mcgurk/Controller_adapter_for_NES/README.md

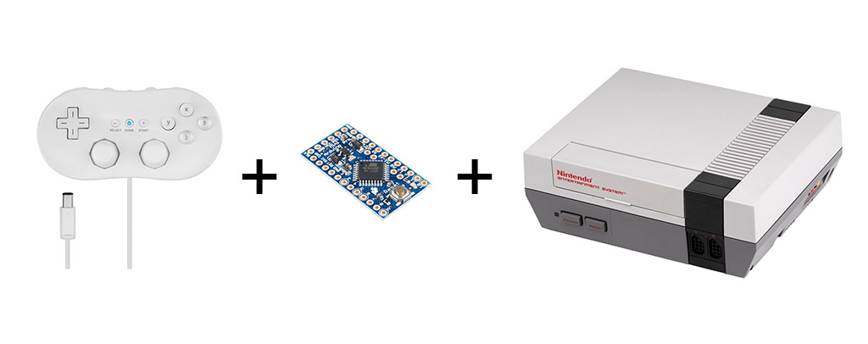
[picture p1: Images/Wii-Classic-Controller_Arduino_NES.jpg]


# Wii Classic Controller to NES

Works with normal Arduino with Atmega328P (5V 16MHz). I used Arduino Pro Mini (Arduino Pro Mini doesn't include USB-port - needs USB-serial adapter for programming). Arduino Nano may be better option, because it includes USB-port.

Lag under 1ms.

Compatible with PAL (50Hz) and NTSC (60Hz) (NTSC support not tested).

Arduino Pro Mini, AMS1117 regulator, signal voltage converter and Wii Classic Controller altogether 28mA.

## Images

https://github.com/mcgurk/Controller_adapter_for_NES/raw/master/Images/2016-11-10%2011.08.51.jpg

https://github.com/mcgurk/Controller_adapter_for_NES/raw/master/Images/2016-11-10%2011.23.53.jpg

## Connections

### Wii Classic Controller (I²C)



Arduino Uno/Pro Mini (ATmega328P): SDA = A4, SCL = A5

Leonardo/Pro Micro (ATmega32u4): SDA = D2, SCL = D3 (With ATmega32u4 you have to use some other pins for NES) 

Officially Wii extension controllers are 3.3V.  Might work with 5V. I used level converter with 3.3V AMS1117 regulator. Search from Ebay with Logic Level Converter Module AMS1117 DC 5V to 3.3V

### NES-controller:



- Pin 8 NES data (D1) 
- Pin 2 NES latch (OUT 0)
- Pin 3 NES pulse (clock/CUP)

(Latch and pulse must be interrupt pins: https://www.arduino.cc/en/Reference/AttachInterrupt)

## Links

http://www.mit.edu/~tarvizo/nes-controller.html

https://www.arduino.cc/en/Reference/PortManipulation

## PAL vs NTSC NES clock signal
PAL NES clock signal is differs from NTSC signal.

Here is NTSC-signal (clock signal changes every 6µs): http://quinndunki.com/blondihacks/?p=1461
NTSC NES

Here is PAL-signal (clock signal goes down only for 250ns):

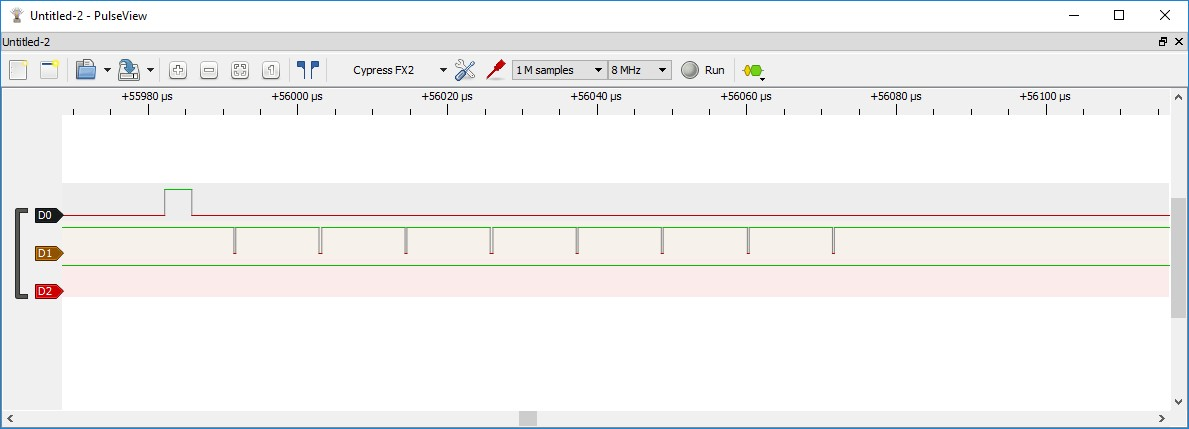
[picture p2: Images/NES_PAL.jpg]
PAL NES


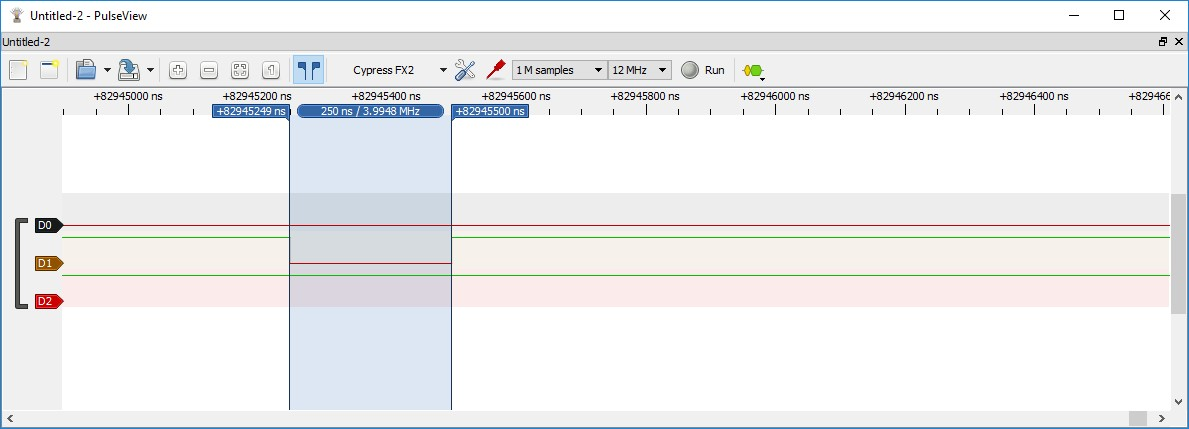
[picture p3: Images/NES_PAL_pulse.jpg]
PAL NES - one pulse


(signal captured with "CY7C68013A-56 EZ-USB FX2LP USB2.0 Develope Board Module Logic Analyzer EEPROM ME" and sigrok.org software)
