mcgurk/Controller_adapter_for_NES/Images/2016-11-10 11.08.51.jpg

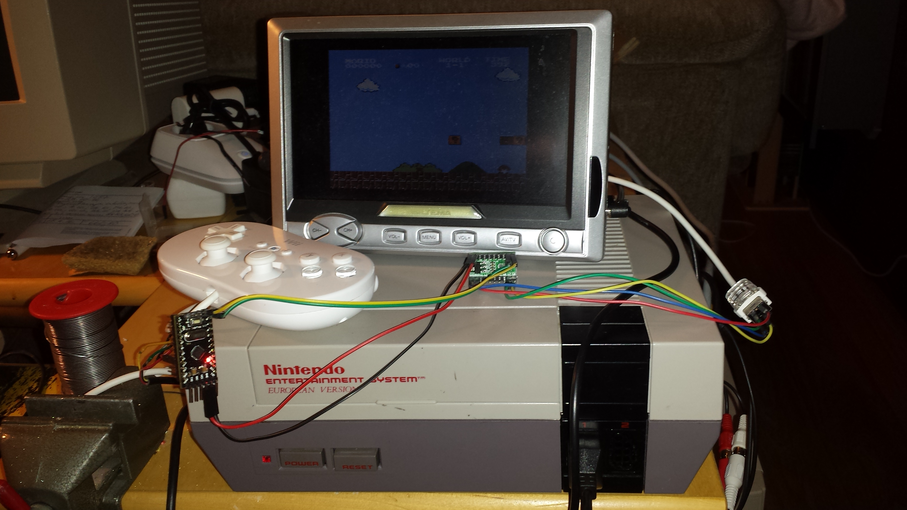
Images/2016-11-10 11.08.51.jpg
