mcgurk/Controller_adapter_for_NES/Images/2016-11-10 11.23.53.jpg

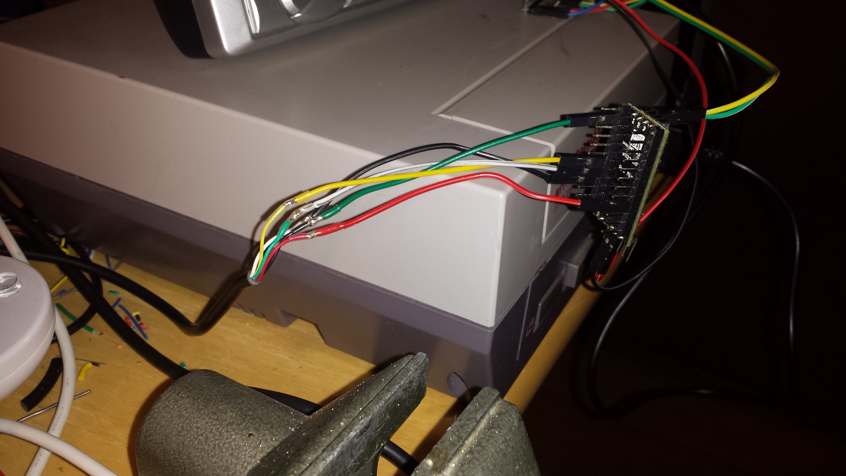
Images/2016-11-10 11.23.53.jpg
